octovolt/SlowEdgeStripboard/SlowEdgeStripboard.kicad_sch

## KiCad design SlowEdgeStripboard.kicad_sch (2024-01-03)

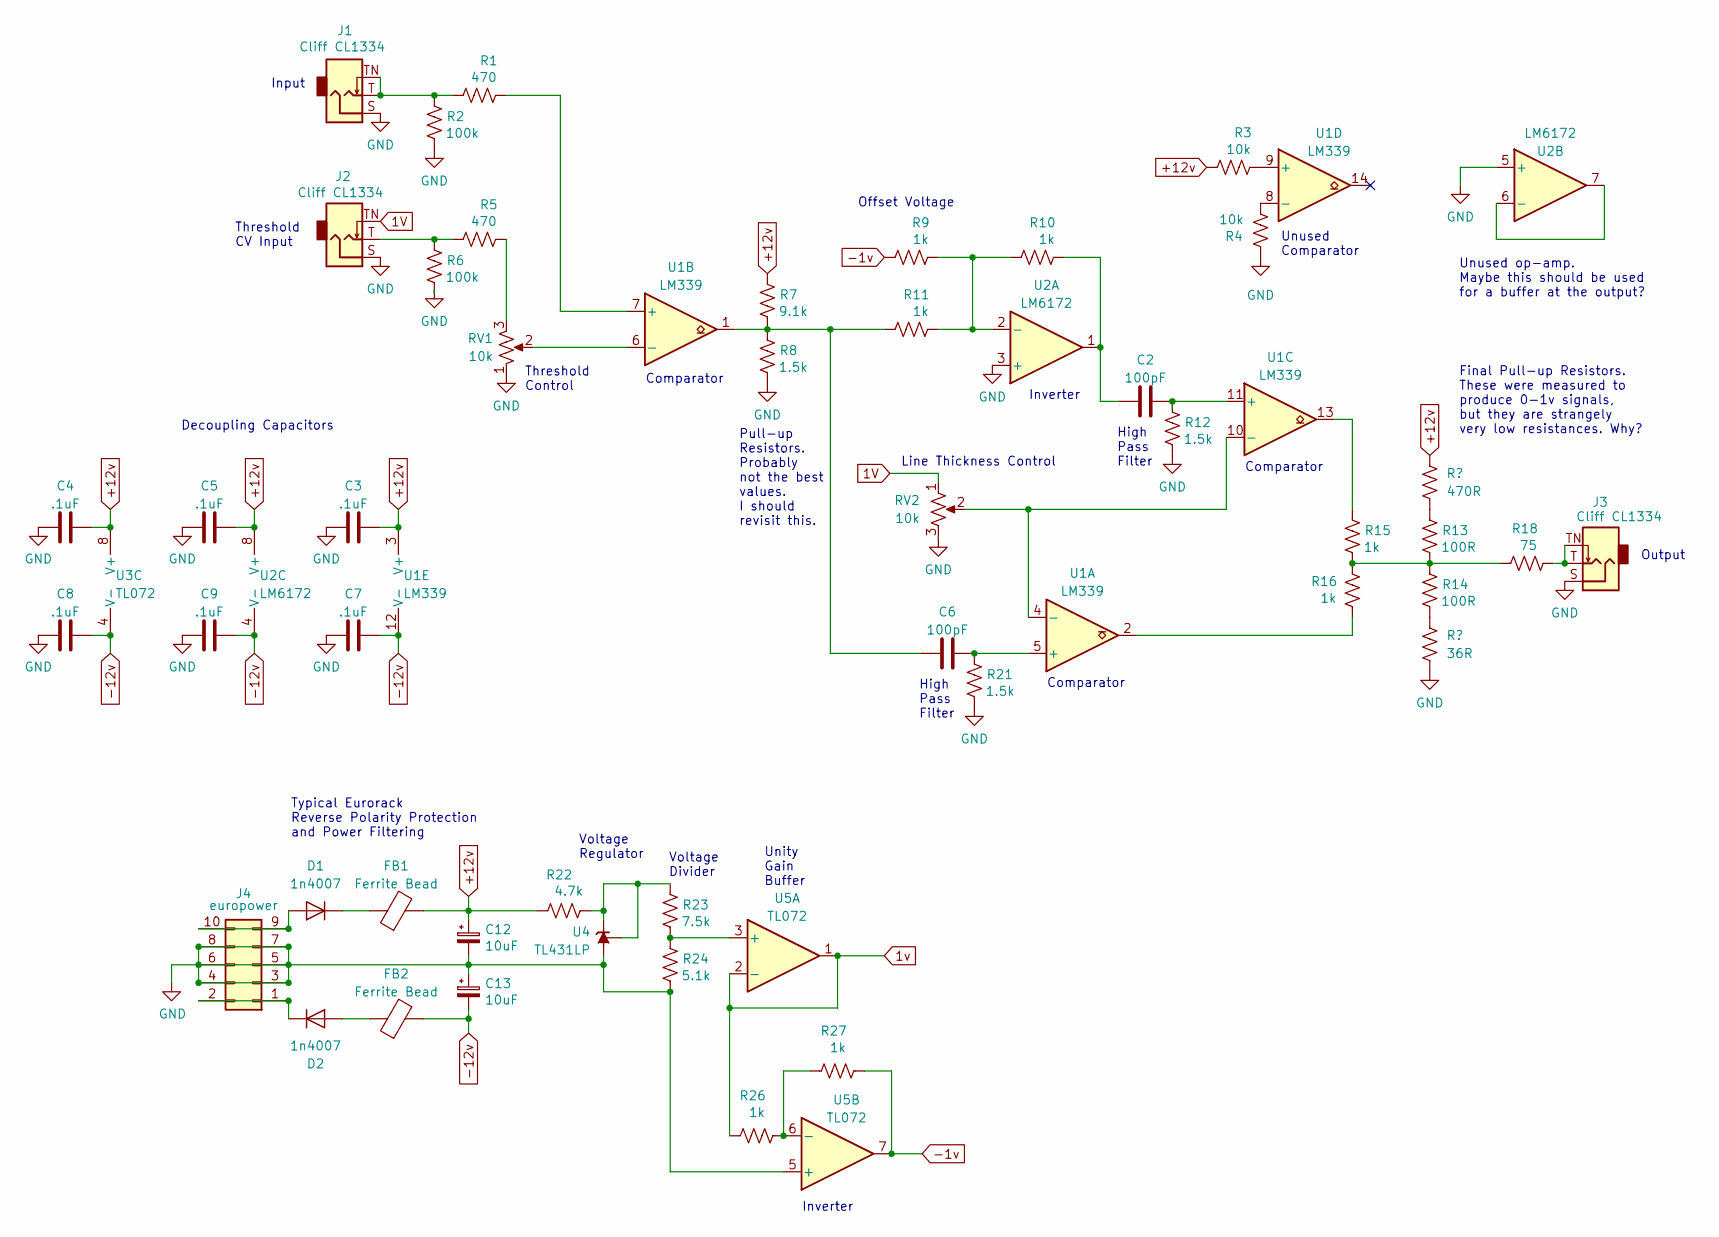
[picture p2: schematic SlowEdgeStripboard.kicad_sch]

Parts:
C2, C6: 100pF; C_Disc_D5.0mm_W2.5mm_P5.00mm
C3, C4, C5, C7, C8, C9: .1uF; C_Disc_D5.0mm_W2.5mm_P5.00mm
C12, C13: 10uF; CP_Radial_D5.0mm_P2.50mm
D1, D2: 1n4007; D_DO-41_SOD81_P7.62mm_Horizontal
FB1, FB2: Ferrite Bead; R_Axial_DIN0207_L6.3mm_D2.5mm_P7.62mm_Horizontal
J1, J2, J3: Cliff CL1334
J4: europower; IDC-Header_2x05_P2.54mm_Vertical
R1, R5: 470; R_Axial_DIN0204_L3.6mm_D1.6mm_P5.08mm_Horizontal
R2, R6: 100k; R_Axial_DIN0204_L3.6mm_D1.6mm_P5.08mm_Horizontal
R3, R4: 10k; R_Axial_DIN0204_L3.6mm_D1.6mm_P5.08mm_Horizontal
R7: 9.1k; R_Axial_DIN0204_L3.6mm_D1.6mm_P5.08mm_Horizontal
R8, R12, R21: 1.5k; R_Axial_DIN0204_L3.6mm_D1.6mm_P5.08mm_Horizontal
R9, R10, R11, R15, R16, R26, R27: 1k; R_Axial_DIN0204_L3.6mm_D1.6mm_P5.08mm_Horizontal
R13, R14: 100R; R_Axial_DIN0204_L3.6mm_D1.6mm_P5.08mm_Horizontal
R18: 75; R_Axial_DIN0204_L3.6mm_D1.6mm_P5.08mm_Horizontal
R22: 4.7k; R_Axial_DIN0204_L3.6mm_D1.6mm_P5.08mm_Horizontal
R23: 7.5k; R_Axial_DIN0204_L3.6mm_D1.6mm_P5.08mm_Horizontal
R24: 5.1k; R_Axial_DIN0204_L3.6mm_D1.6mm_P5.08mm_Horizontal
RV1, RV2: 10k; Alpha9mmPot
U1: LM339; DIP-14_W7.62mm
U2: LM6172; DIP-8_W7.62mm
U3, U5: TL072; DIP-8_W7.62mm
U4: TL431LP; TO-92_HandSolder

Connections:
1V: J2.TN, R26.1, RV2.1, U5.1, U5.2 (-)
+12v: C3.2, C4.2, C5.2, C12.1, FB1.2, R3.1, R7.1, R22.1, U1.3 (V+), U2.8 (V+), U3.8 (V+)
-1v: R9.1, R27.2, U5.7
-12v: C7.2, C8.2, C9.2, C13.2, FB2.2, U1.12 (V-), U2.4 (V-), U3.4 (V-)
GND: C3.1, C4.1, C5.1, C7.1, C8.1, C9.1, C12.2, C13.1, J1.S, J2.S, J3.S, J4.3, J4.4, J4.5, J4.6, J4.7, J4.8, R2.2, R4.1, R6.2, R8.2, R12.2, R21.2, R24.2, RV1.1, RV2.3, U2.3 (+), U4.2 (A), U5.5 (+)
unnamed: C2.1, R10.2, U2.1
unnamed: C2.2, R12.1, U1.11 (+)
unnamed: C6.1, R7.2, R8.1, R11.1, U1.1
unnamed: C6.2, R21.1, U1.5 (+)
unnamed: D1.1 (K), FB1.1
unnamed: D1.2 (A), J4.9, J4.10
unnamed: D2.1 (K), J4.1, J4.2
unnamed: D2.2 (A), FB2.1
unnamed: J1.T, J1.TN, R1.1, R2.1
unnamed: J2.T, R5.1, R6.1
unnamed: J3.T, J3.TN, R18.2
unnamed: R1.2, U1.7 (+)
unnamed: R3.2, U1.9 (+)
unnamed: R4.2, U1.8 (-)
unnamed: R5.2, RV1.3
unnamed: R9.2, R10.1, R11.2, U2.2 (-)
unnamed: R13.2, R14.1, R15.2, R16.2, R18.1
unnamed: R15.1, U1.13
unnamed: R16.1, U1.2
unnamed: R22.2, R23.1, U4.1 (REF), U4.3 (K)
unnamed: R23.2, R24.1, U5.3 (+)
unnamed: R26.2, R27.1, U5.6 (-)
unnamed: RV1.2, U1.6 (-)
unnamed: RV2.2, U1.4 (-), U1.10 (-)
unnamed: U2.6 (-), U2.7

Notes on the sheet:
Typical Eurorack Reverse Polarity Protection and Power Filtering
Comparator
Offset Voltage
Decoupling Capacitors
Threshold CV Input
High Pass Filter
Pull-up Resistors. Probably not the best values. I should revisit this.
Input
Output
Unity Gain Buffer
Voltage Regulator
Inverter
Voltage Divider
Final Pull-up Resistors. These were measured to produce 0-1v signals, but they are strangely very low resistances. Why?
Unused op-amp. Maybe this should be used for a buffer at the output?
Threshold Control
Unused Comparator
Line Thickness Control
