octovolt/SlowEdgeStripboard/(commit log)

2024-01-03 add KiCAD files
    [SlowEdgeStripboard.kicad_sch]
2024-01-03 add schematic
